ryantay8921/ECE129--Wet-Dry-Cycler-for-RNA-Research-prototype/README.md

# ECE129--Wet-Dry-Cycler-for-RNA-Research-prototype
