ryantay8921/ECE129--Wet-Dry-Cycler-for-RNA-Research-prototype/pcb_v2/pcb/pcb.kicad_pcb

## KiCad design pcb_v2/pcb/pcb.kicad_pcb (2026-04-23)

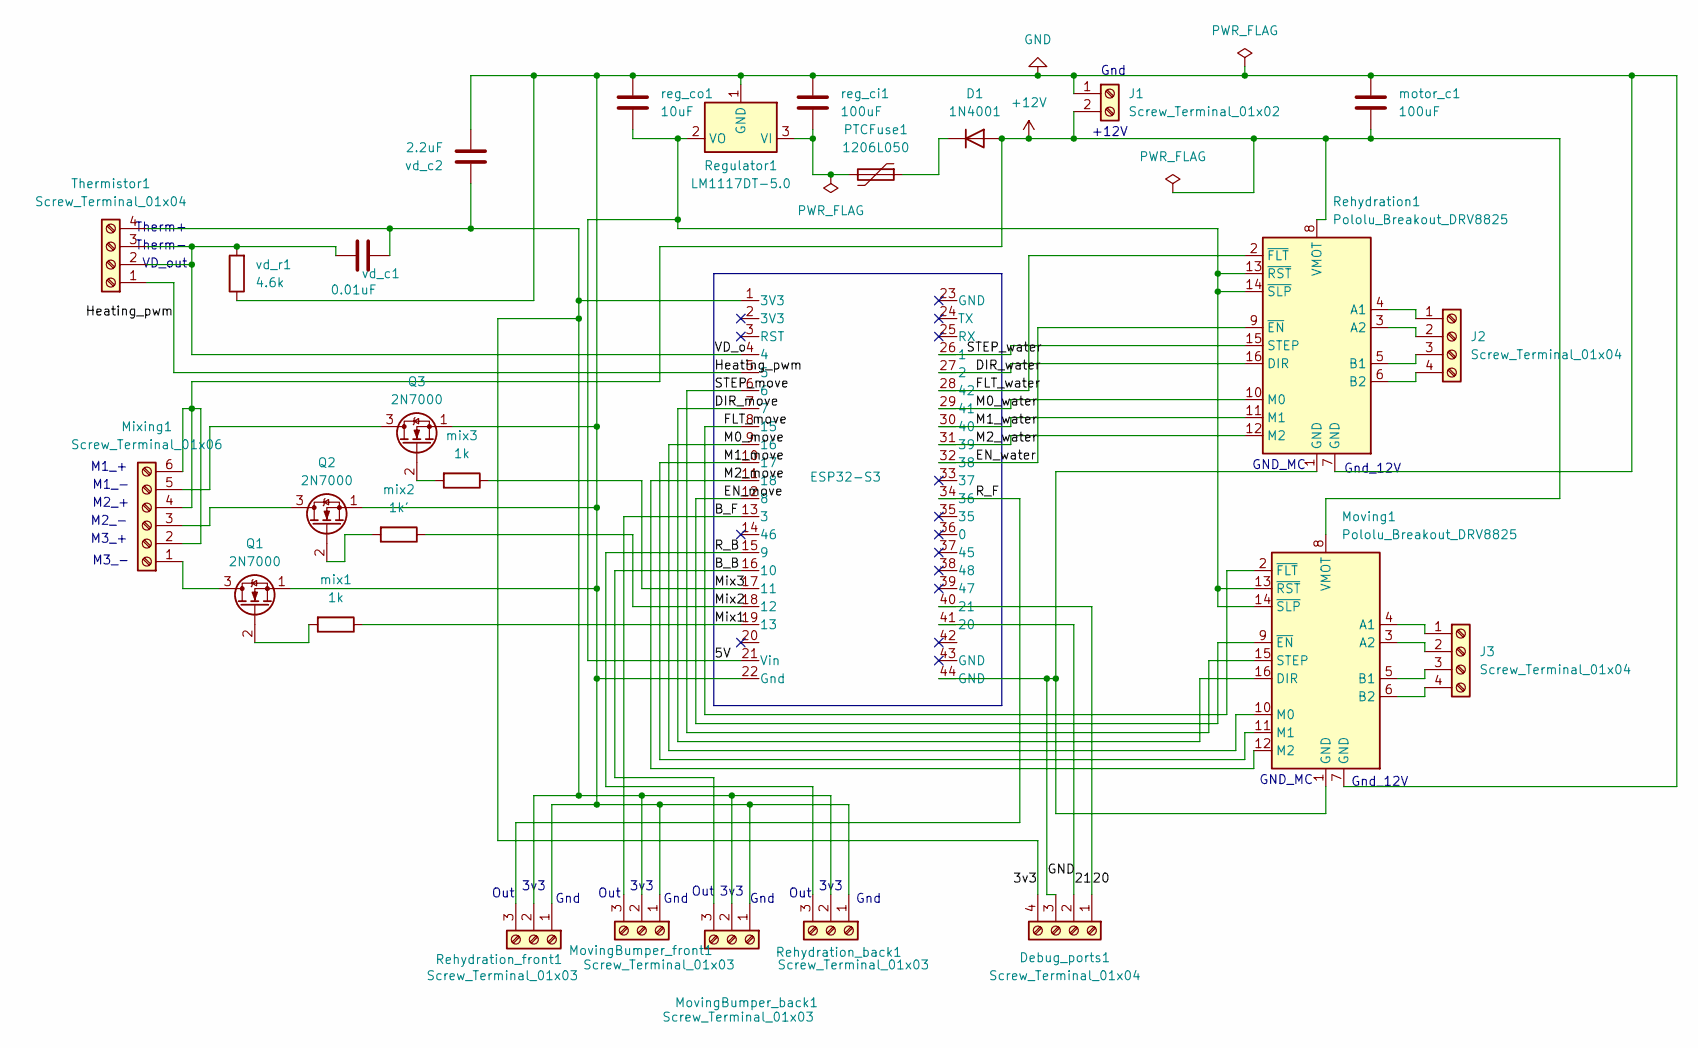
[picture p1: schematic pcb.kicad_sch, PCB Schematic for Wet-Dry Cycling]

Parts:
D1: 1N4001; D_DO-41_SOD81_P10.16mm_Horizontal
Debug_ports1: Screw_Terminal_01x04; TerminalBlock_MaiXu_MX126-5.0-04P_1x04_P5.00mm
ESP32-S3: ESP32_DevKitC_Header_Mount
J1: Screw_Terminal_01x02; TerminalBlock_MaiXu_MX126-5.0-02P_1x02_P5.00mm
J2, J3: Screw_Terminal_01x04; TerminalBlock_MaiXu_MX126-5.0-04P_1x04_P5.00mm
Mixing1: Screw_Terminal_01x06; TerminalBlock_MaiXu_MX126-5.0-06P_1x06_P5.00mm
Moving1: Pololu_Breakout_DRV8825; Pololu_Breakout-16_15.2x20.3mm
MovingBumper_back1: Screw_Terminal_01x03; TerminalBlock_MaiXu_MX126-5.0-03P_1x03_P5.00mm
MovingBumper_front1: Screw_Terminal_01x03; TerminalBlock_MaiXu_MX126-5.0-03P_1x03_P5.00mm
PTCFuse1: 1206L050; Fuse_1206_3216Metric_Pad1.42x1.75mm_HandSolder
Q1, Q2, Q3: 2N7000; TO-92_Inline
Regulator1: LM1117DT-5.0; TO-252-3_TabPin2
Rehydration1: Pololu_Breakout_DRV8825; Pololu_Breakout-16_15.2x20.3mm
Rehydration_back1: Screw_Terminal_01x03; TerminalBlock_MaiXu_MX126-5.0-03P_1x03_P5.00mm
Rehydration_front1: Screw_Terminal_01x03; TerminalBlock_MaiXu_MX126-5.0-03P_1x03_P5.00mm
Thermistor1: Screw_Terminal_01x04; TerminalBlock_MaiXu_MX126-5.0-04P_1x04_P5.00mm
mix1, mix3: 1k; R_0805_2012Metric_Pad1.20x1.40mm_HandSolder
mix2: 1k'; R_0805_2012Metric_Pad1.20x1.40mm_HandSolder
motor_c1: 100uF; C_0805_2012Metric_Pad1.18x1.45mm_HandSolder
reg_ci1: 100uF; C_0805_2012Metric_Pad1.18x1.45mm_HandSolder
reg_co1: 10uF; C_0805_2012Metric_Pad1.18x1.45mm_HandSolder
vd_c1: 0.01uF; C_0805_2012Metric_Pad1.18x1.45mm_HandSolder
vd_c2: 2.2uF; C_0805_2012Metric_Pad1.18x1.45mm_HandSolder
vd_r1: 4.6k; R_0805_2012Metric_Pad1.20x1.40mm_HandSolder

Connections:
+12V: D1.2 (A), J1.2, Mixing1.2, Mixing1.4, Mixing1.6, Moving1.8 (VMOT), Rehydration1.8 (VMOT), motor_c1.2
/3v3: Debug_ports1.4, ESP32-S3.1 (3V3), MovingBumper_back1.2, MovingBumper_front1.2, Rehydration_back1.2, Rehydration_front1.2, Thermistor1.4, vd_c1.2, vd_c2.1
/5V: ESP32-S3.21 (Vin), Moving1.13 (~RST), Moving1.14 (~SLP), Regulator1.2 (VO), Rehydration1.13 (~RST), Rehydration1.14 (~SLP), reg_co1.2
/20: Debug_ports1.1, ESP32-S3.40 (21)
/21: Debug_ports1.2, ESP32-S3.41 (20)
/B_B: ESP32-S3.16 (10), MovingBumper_back1.3
/B_F: ESP32-S3.13 (3), MovingBumper_front1.3
/DIR_move: ESP32-S3.7, Moving1.16 (DIR)
/DIR_water: ESP32-S3.27 (2), Rehydration1.16 (DIR)
/EN_move: ESP32-S3.12 (8), Moving1.9 (~EN)
/EN_water: ESP32-S3.32 (38), Rehydration1.9 (~EN)
/FLT_move: ESP32-S3.8 (15), Moving1.2 (~FLT)
/FLT_water: ESP32-S3.28 (42), Rehydration1.2 (~FLT)
/Heating_pwm: ESP32-S3.5, Thermistor1.1
/M0_move: ESP32-S3.9 (16), Moving1.10 (M0)
/M0_water: ESP32-S3.29 (41), Rehydration1.10 (M0)
/M1_move: ESP32-S3.10 (17), Moving1.11 (M1)
/M1_water: ESP32-S3.30 (40), Rehydration1.11 (M1)
/M2_move: ESP32-S3.11 (18), Moving1.12 (M2)
/M2_water: ESP32-S3.31 (39), Rehydration1.12 (M2)
/Mix1: ESP32-S3.19 (13), mix1.1
/Mix2: ESP32-S3.18 (12), mix2.1
/Mix3: ESP32-S3.17 (11), mix3.1
/R_B: ESP32-S3.15 (9), Rehydration_back1.3
/R_F: ESP32-S3.34 (36), Rehydration_front1.3
/STEP_move: ESP32-S3.6, Moving1.15 (STEP)
/STEP_water: ESP32-S3.26 (1), Rehydration1.15 (STEP)
/VD_o: ESP32-S3.4, Thermistor1.2, Thermistor1.3, vd_c1.1, vd_r1.2
GND: Debug_ports1.3, ESP32-S3.22 (Gnd), ESP32-S3.44 (GND), J1.1, Moving1.1 (GND), Moving1.7 (GND), MovingBumper_back1.1, MovingBumper_front1.1, Q1.1 (S), Q2.1 (S), Q3.1 (S), Regulator1.1 (GND), Rehydration1.1 (GND), Rehydration1.7 (GND), Rehydration_back1.1, Rehydration_front1.1, motor_c1.1, reg_ci1.1, reg_co1.1, vd_c2.2, vd_r1.1
unnamed: D1.1 (K), PTCFuse1.1
unnamed: J2.1, Rehydration1.4 (A1)
unnamed: J2.2, Rehydration1.3 (A2)
unnamed: J2.3, Rehydration1.5 (B1)
unnamed: J2.4, Rehydration1.6 (B2)
unnamed: J3.1, Moving1.4 (A1)
unnamed: J3.2, Moving1.3 (A2)
unnamed: J3.3, Moving1.5 (B1)
unnamed: J3.4, Moving1.6 (B2)
unnamed: Mixing1.1, Q1.3 (D)
unnamed: Mixing1.3, Q2.3 (D)
unnamed: Mixing1.5, Q3.3 (D)
unnamed: Q1.2 (G), mix1.2
unnamed: Q2.2 (G), mix2.2
unnamed: Q3.2 (G), mix3.2
unnamed: PTCFuse1.2, Regulator1.3 (VI), reg_ci1.2

Notes on the sheet:
Out
3v3
M2_-
Gnd_12V
Gnd
Therm-
+12V
GND_MC
M1_+
M2_+
M1_-
M3_-
M3_+
Therm+
VD_out

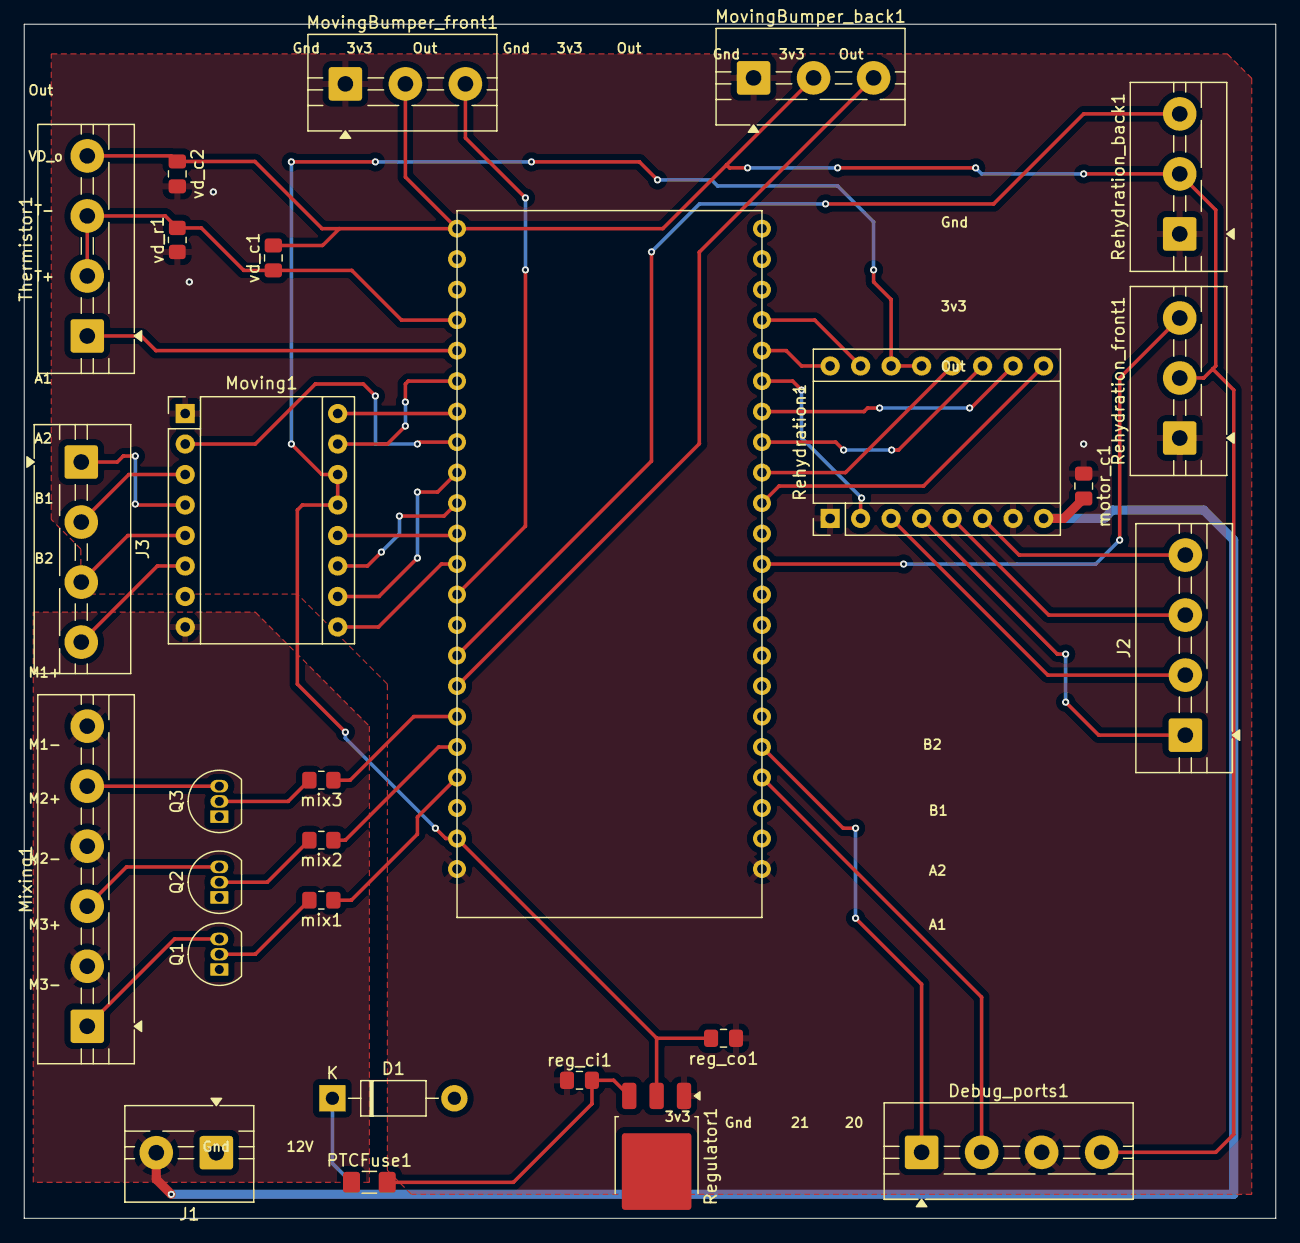
[picture p2: board pcb.kicad_pcb from above]

Board: 2 copper layers, 104.2 x 99.5 mm, 28 parts (0 on the bottom side), 45 nets.
