ryantay8921/ECE129--Wet-Dry-Cycler-for-RNA-Research-prototype/(commit log)

2025-07-07 Added syringe refill popup message check
2025-07-07 Fixing pausing and percentage sent
    [globals.cpp, handle_functions.cpp, handle_functions.h, main.cpp, state_websocket.cpp]
2025-07-07 Fixing unknown state, and syringe bumper press
    [DRV8825.cpp, REHYDRATION.cpp, globals.cpp, globals.h, handle_functions.cpp, main.cpp, send_functions.cpp, send_functions.h]
2025-07-08 added syringe status stuff
2025-07-11 Switching order of states and new code that should be tested in (DRV, handle, REHYDRATION and main)
2025-07-11 Added a countdown timer to front end
2025-07-14 timer pause resume loses a couple seconds, but works good enough
2025-07-15 Adding changes in mixing in order to be able to control the speed of the mixing motors with PWM. (Frequency of PWM set low(500Hz) to protect the mosfet controlling the motors) branch 'main' into LabB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
2026-04-23 final report
    [12V Power Supply.kicad_sch, Heating_controller.kicad_sch, Regulator.kicad_sch, VoltageDivider.kicad_sch, Wet_Dry Cycling.kicad_pcb, Wet_Dry Cycling.kicad_sch, mixing_control.kicad_sch, pcb.kicad_pcb]
